WROTeamTrinity/WRO2025Trinity/3D Model Design/Readme.md

# 3D Models

This directory contains 3D models of the robot. The models are in the [STL](https://en.wikipedia.org/wiki/STL_(file_format)) format.
