WROTeamTrinity/WRO2025Trinity/Others/README/pixy 1.jpg

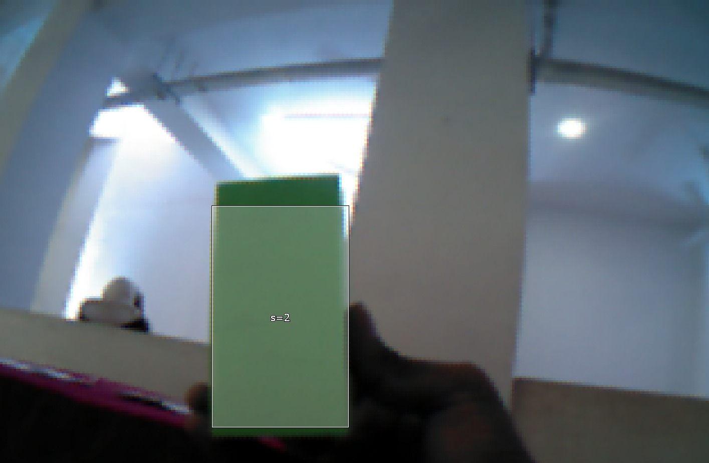
Others/README/pixy 1.jpg
