WROTeamTrinity/WRO2025Trinity/Others/README/pixy 2.jpg

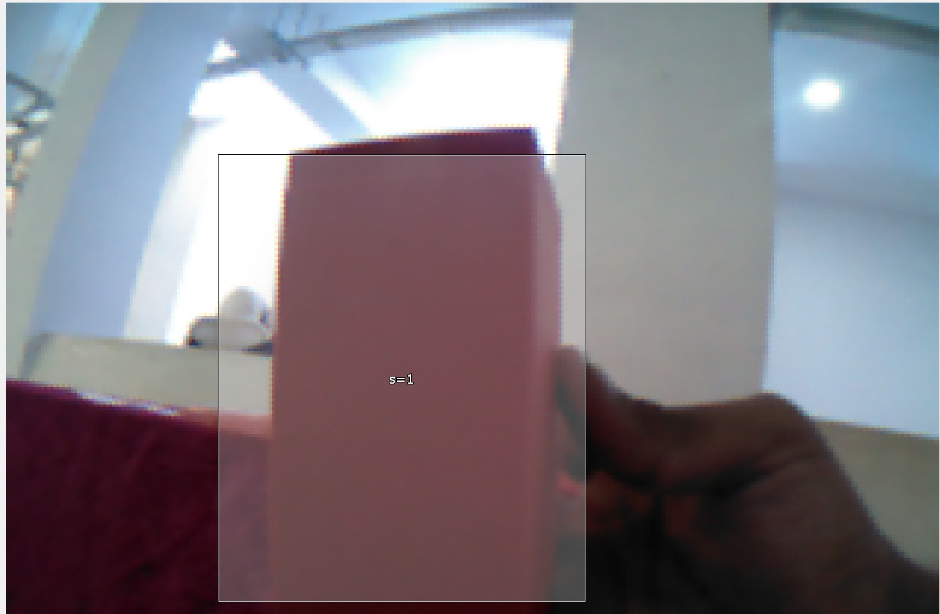
Others/README/pixy 2.jpg
