WROTeamTrinity/WRO2025Trinity/(commit log)

2025-08-23 Create code
    camera code
2025-08-23 Add files via upload
    camera_with mega
2025-08-23 Add files via upload
    added camera_sonar
2025-08-23 Delete src/camera_code/code
    deeleted
